loggerhead-instruments/HS1/(list of files, drawings)

Other design files:
Altium/HS1.PcbDoc
Altium/HS1.PrjPCB
Altium/HS1.SchDoc
Altium/HS1_audio.SchDoc
