loggerhead-instruments/HS1/Arduino/HS1/powerEstimate.ino

float mAmpRec = 80.0;
float mAmpSleep = 80.0;

float mAhPerBat = 12000.0; // assume 4.5Ah per LiPo; rated at 5 Ah

uint32_t freeMB;
uint32_t filesPerCard;
csd_t m_csd;

void getCardSpace(){
  // get free space on cards
    cDisplay();
    display.println("HS1");
    display.setCursor(0, displayLine3);
    display.print("Card Free/Total MB");

    sd.card()->readCSD(&m_csd);
    
    //uint32_t volFree = sd.FsVolume.freeClusterCount();
    uint32_t volMB = uint32_t ( 0.000512 * sdCardCapacity(&m_csd));    
    
    Serial.print("Volume (MB): ");
    Serial.println((uint32_t) volMB);

    if (volMB < 200) freeMB = 0;
    else
      freeMB = volMB - 200; // take off 200 MB to be safe

    display.setCursor(0, displayLine4);
    display.print(freeMB);
    display.print("/");
    display.println(volMB);
    display.display();
}

void updatePowerDuration(){
  uint32_t totalRecSeconds = 0;
  audio_srate = lhi_fsamps[isf];
  float fileBytes = (2 * rec_dur * audio_srate) + 44;
  float fileMB = (fileBytes + 32768) / 1000 / 1000; // add cluster size so don't underestimate fileMB

  float recDraw = mAmpRec;
  float recFraction = (float) rec_dur / (float) (rec_dur + rec_int);
  float sleepFraction = 1 - recFraction;  
  float avgCurrentDraw = (recDraw * recFraction) + (mAmpSleep * sleepFraction);

  uint32_t powerSeconds = uint32_t (3600.0 * nBatPacks * (mAhPerBat / avgCurrentDraw));

  filesPerCard = 0;
  if(freeMB==0) filesPerCard = 0;
  else{
    filesPerCard = (uint32_t) floor(freeMB / fileMB);
  }
  totalRecSeconds += (filesPerCard * rec_dur);
  float totalSecondsMemory = totalRecSeconds / recFraction;

//  if(printDiags){
//    Serial.print("Free MB: "); Serial.println(freeMB);
//    Serial.print("File MB: "); Serial.println(fileMB);
//    Serial.print("FilesPerCard: "); Serial.println(filesPerCard);
//    Serial.print("Memory Dur (s): "); Serial.println(totalSecondsMemory);
//    Serial.print("Rec dur:"); Serial.println(rec_dur);
//    Serial.print("Sleep dur:"); Serial.println(rec_int);
//    Serial.print("Rec fraction:"); Serial.println(recFraction);
//    Serial.print("Sleep fraction:"); Serial.println(sleepFraction);
//    Serial.print("Avg power mA:"); Serial.println(avgCurrentDraw);
//  }

  
  if(powerSeconds < totalSecondsMemory){
    display.setCursor(0, displayLine5);
    display.print("Battery Limit:");
    display.print(powerSeconds / 86400);
    display.print("d");
    recDays = powerSeconds / 86400.0;
  }
  else{
    display.setCursor(0, displayLine5);
    display.print("Memory Limit:");
    display.print(totalSecondsMemory / 86400);
    display.print("d");
    recDays = totalSecondsMemory / 86400.0;
  }
}
