loggerhead-instruments/HS1/(commit log)

2019-07-05 add fiducials
    [HS1.PcbDoc]
2019-07-18 display and test high sample rates
2019-07-20 fix display and power calcs
    [HS1.ino, display.ino, manualSettings.ino, powerEstimate.ino]
2019-07-30 fix display.printf
    was causing crash
    [manualSettings.ino, powerEstimate.ino]
2019-07-30 update power estimate
2019-11-19 add LTC2955 so get menu only on power on
    [HS1.PcbDoc, HS1.PrjPCB, HS1.SchDoc, Pick Place for HS1.csv]
